AxTheB/Prusa3/box_frame/sample_stls/single_plate_gt2_lm8uu/README.md

# Single plate version with thicker smooth rods
Those parts are for use with *Prusa i3 (single plate) aluminium frame*. Frame blueprints are at https://github.com/josefprusa/Prusa3-vanilla/blob/master/src/alu-frame.dxf
From variable vitamins you need 2x *623 bearings*, 2x *gt2 Pulley with 18-25 teeth*, and a 6mm wide gt2 belts. The bearings are all *lm8uu* (10x) and smooth rods are 8mm.
You will also need extruder, included carriage will take one narrow (for example MGS or geared stepper based) or wade (see extras)
