AxTheB/Prusa3/box_frame/sample_stls/big_htd3_lm12luu/extras/tube_clamp.stl

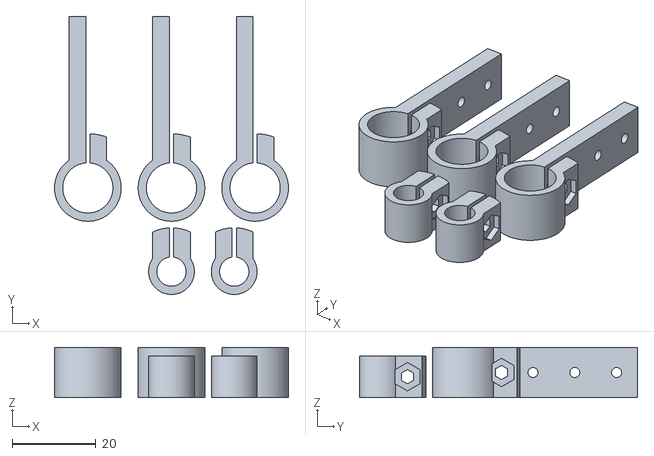
[picture p1: CAD file, 2014-03-03]
box_frame/sample_stls/big_htd3_lm12luu/extras/tube_clamp.stl
56.0 x 66.5 x 12.0
