AxTheB/Prusa3/box_frame/sample_stls/big_htd3_lm12luu/z-axis.stl

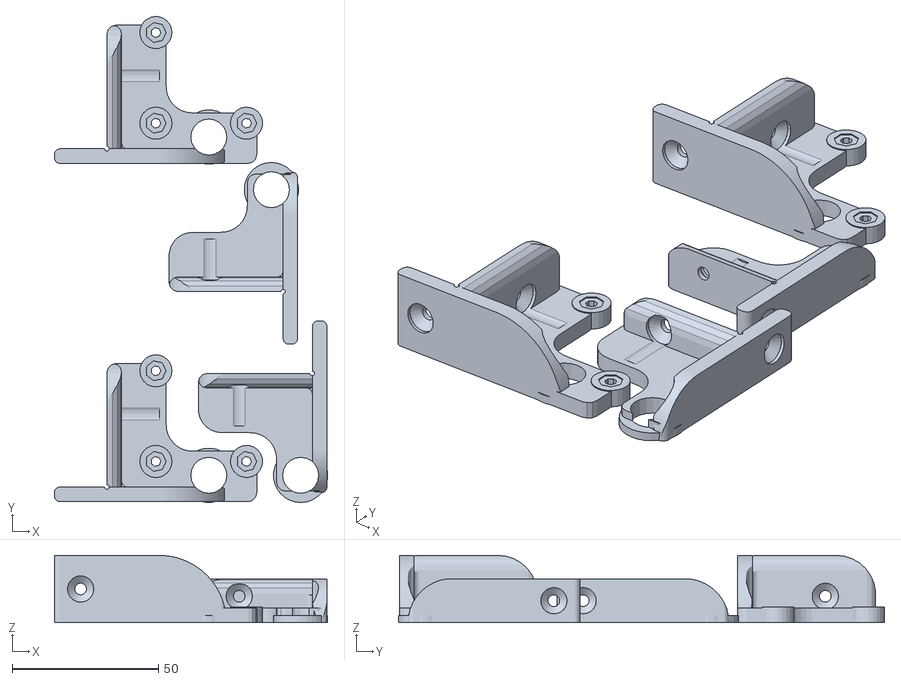
[picture p2: CAD file, 2014-03-03]
box_frame/sample_stls/big_htd3_lm12luu/z-axis.stl
93.5 x 166.2 x 23.0
