AxTheB/Prusa3/box_frame/sample_stls/default_box_gt2_lm10uu/extras/wade-gears.stl

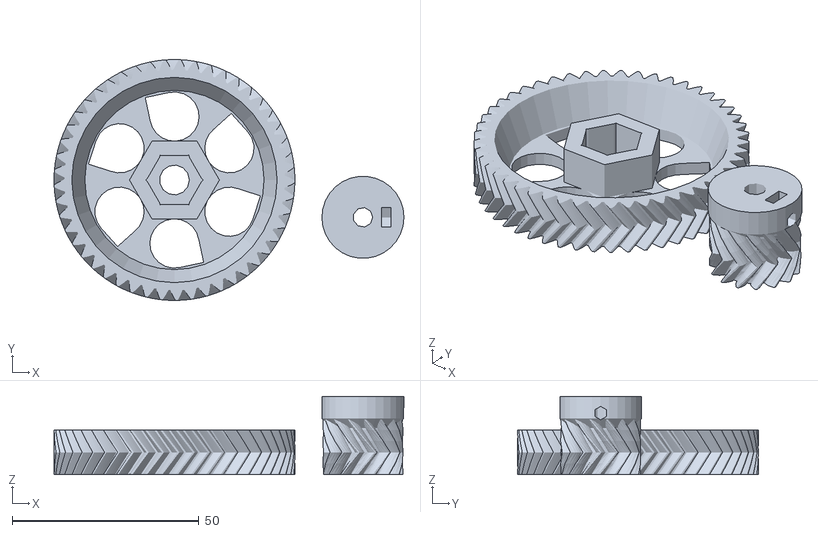
[picture p3: CAD file, 2014-03-03]
box_frame/sample_stls/default_box_gt2_lm10uu/extras/wade-gears.stl
93.8 x 64.5 x 21.0
