AxTheB/Prusa3/box_frame/sample_stls/default_box_gt2_lm10uu/y-drivetrain.stl

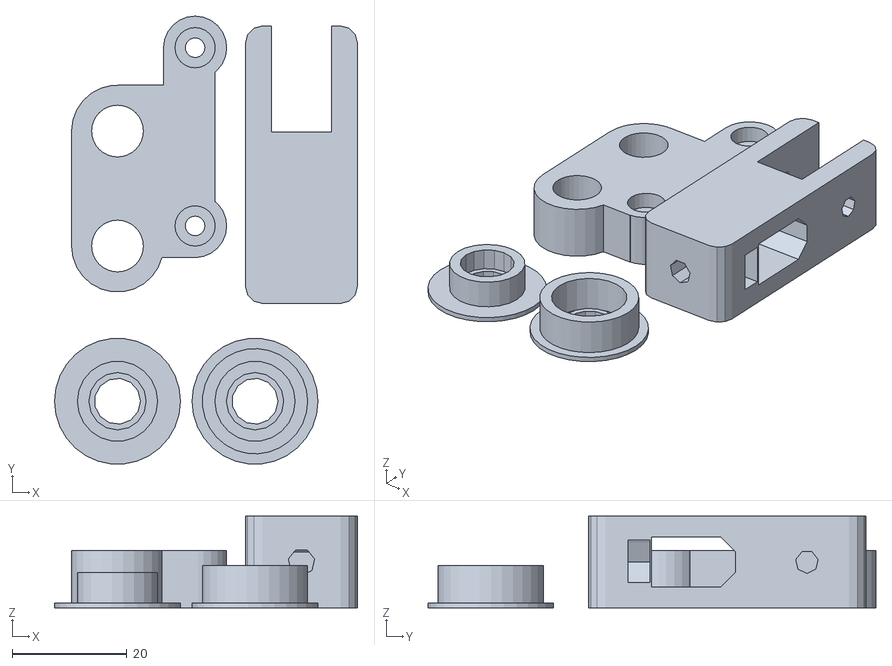
[picture p4: CAD file, 2014-03-03]
box_frame/sample_stls/default_box_gt2_lm10uu/y-drivetrain.stl
52.7 x 77.9 x 16.0
