AxTheB/Prusa3/box_frame/sample_stls/single_plate_gt2_lm8uu/extras/gregs-wade-v3.stl

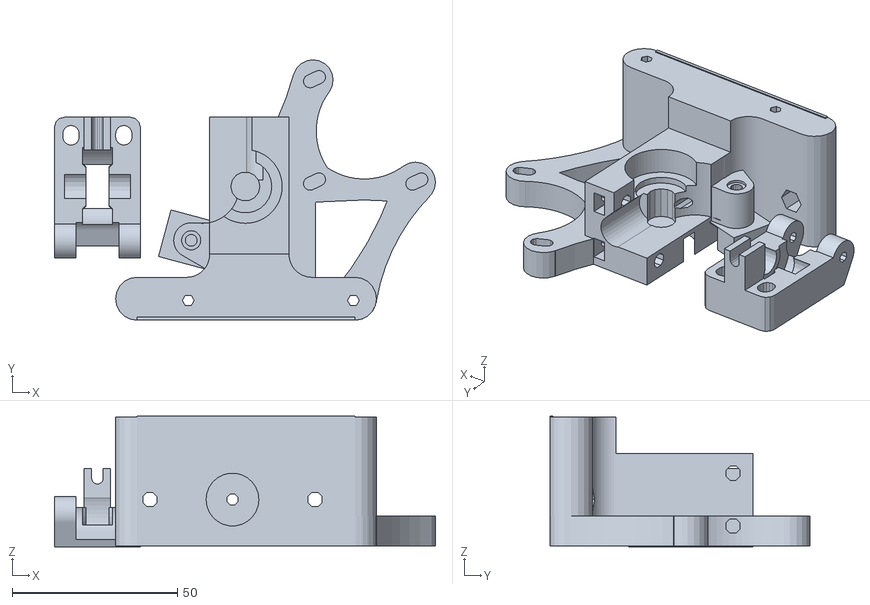
[picture p5: CAD file, 2014-03-03]
box_frame/sample_stls/single_plate_gt2_lm8uu/extras/gregs-wade-v3.stl
115.4 x 78.9 x 39.7
