AxTheB/Prusa3/box_frame/sample_stls/single_plate_gt2_lm8uu/y-axis-corner.stl

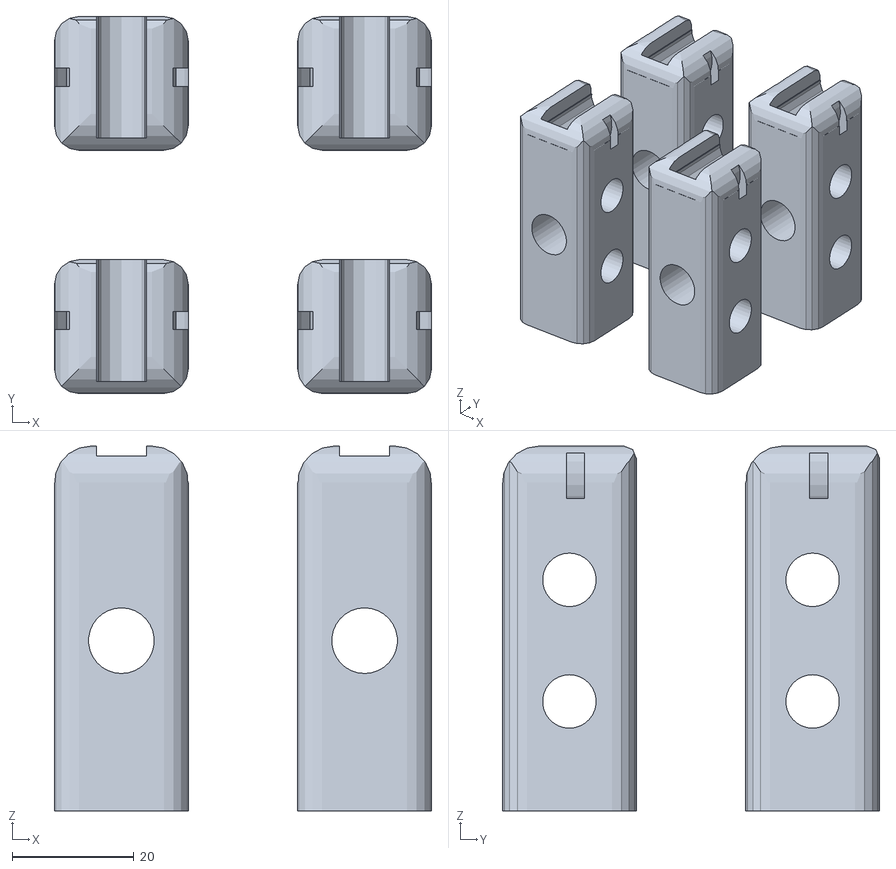
[picture p6: CAD file, 2014-03-03]
box_frame/sample_stls/single_plate_gt2_lm8uu/y-axis-corner.stl
62.0 x 62.0 x 60.0
