AxTheB/Prusa3/box_frame/sample_stls/big_htd3_lm12luu/extras/calibrate.stl

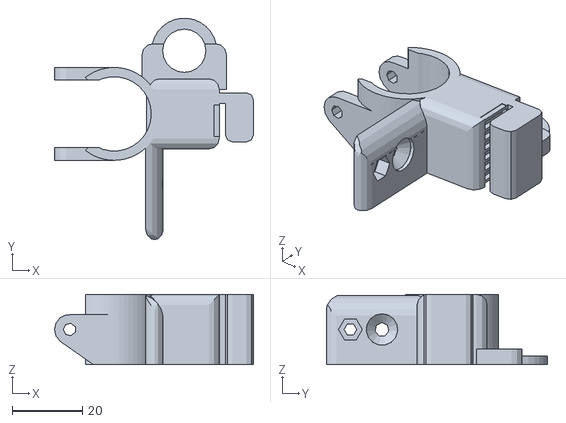
[picture p7: CAD file, 2014-02-11]
box_frame/sample_stls/big_htd3_lm12luu/extras/calibrate.stl
56.8 x 63.1 x 20.0
