AxTheB/Prusa3/box_frame/sample_stls/big_htd3_lm12luu/x-end.stl

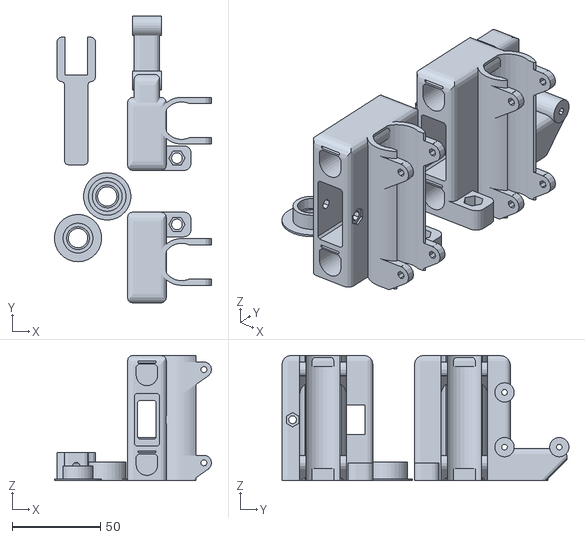
[picture p8: CAD file, 2014-03-03]
box_frame/sample_stls/big_htd3_lm12luu/x-end.stl
89.0 x 162.5 x 70.8
