AxTheB/Prusa3/box_frame/sample_stls/default_box_gt2_lm10uu/x-end.stl

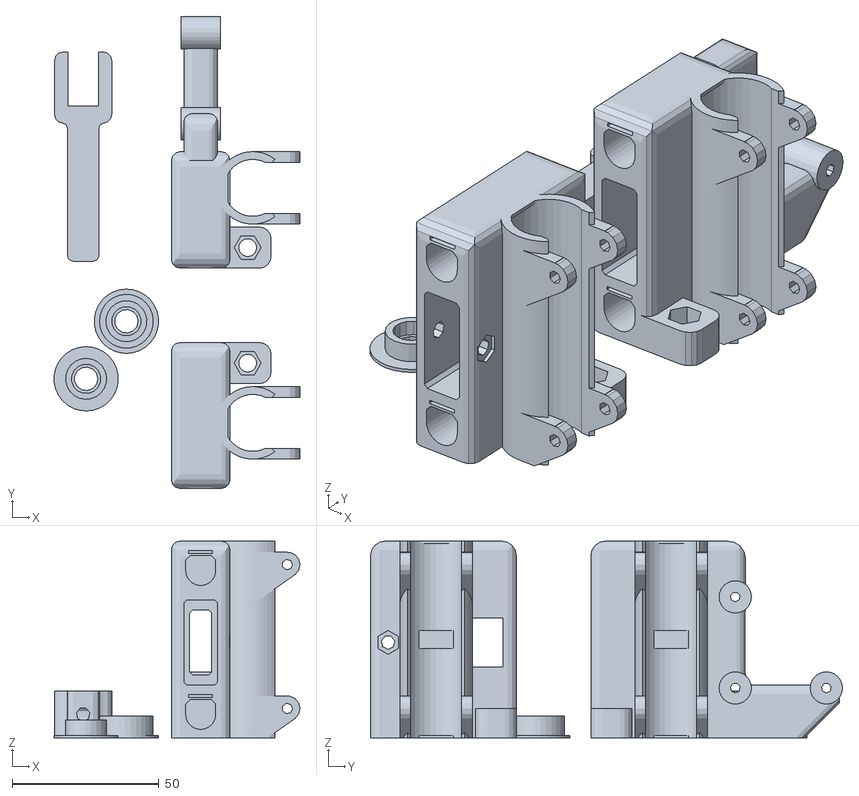
[picture p9: CAD file, 2014-03-03]
box_frame/sample_stls/default_box_gt2_lm10uu/x-end.stl
83.7 x 160.7 x 67.0
