AxTheB/Prusa3/box_frame/sample_stls/big_htd3_lm12luu/x-carriage.stl

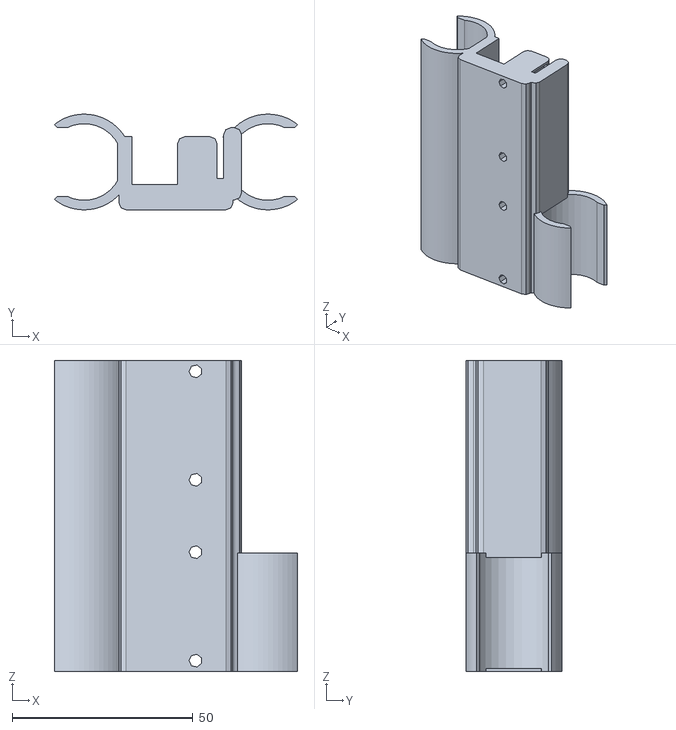
[picture p10: CAD file, 2014-03-03]
box_frame/sample_stls/big_htd3_lm12luu/x-carriage.stl
67.2 x 26.5 x 86.0
