AxTheB/Prusa3/box_frame/sample_stls/default_box_gt2_lm10uu/bushing.stl

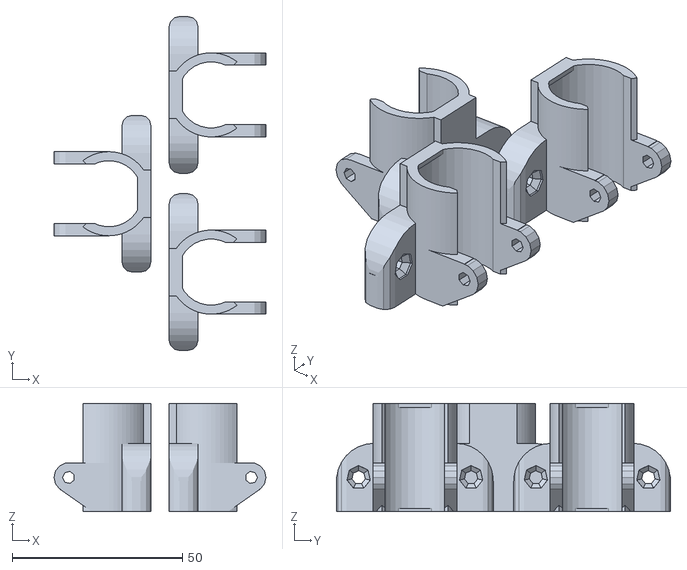
[picture p11: CAD file, 2014-03-03]
box_frame/sample_stls/default_box_gt2_lm10uu/bushing.stl
62.2 x 98.0 x 31.7
