AxTheB/Prusa3/box_frame/sample_stls/single_plate_gt2_lm8uu/extras/calibrate.stl

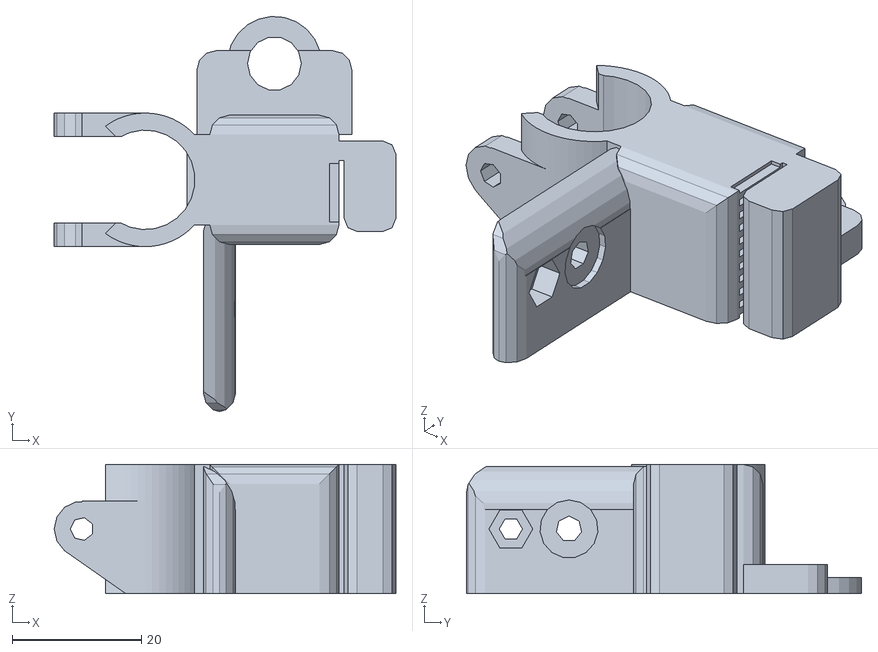
[picture p13: CAD file, 2014-02-11]
box_frame/sample_stls/single_plate_gt2_lm8uu/extras/calibrate.stl
52.9 x 61.1 x 20.0
