AxTheB/Prusa3/box_frame/sample_stls/single_plate_gt2_lm8uu/z-axis.stl

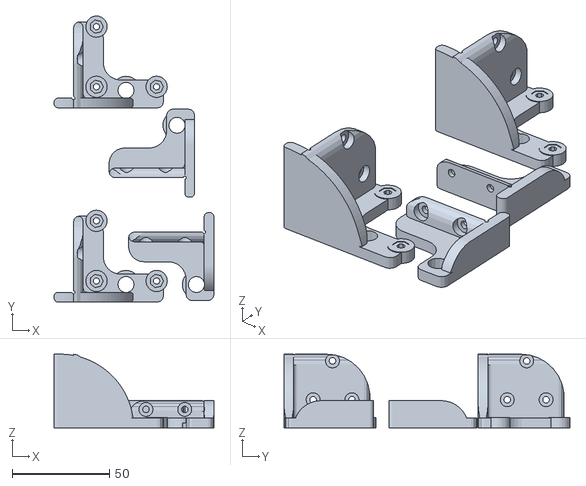
[picture p14: CAD file, 2014-03-03]
box_frame/sample_stls/single_plate_gt2_lm8uu/z-axis.stl
82.3 x 147.4 x 38.0
