AxTheB/Prusa3/box_frame/sample_stls/big_htd3_lm12luu/y-axis-corner.stl

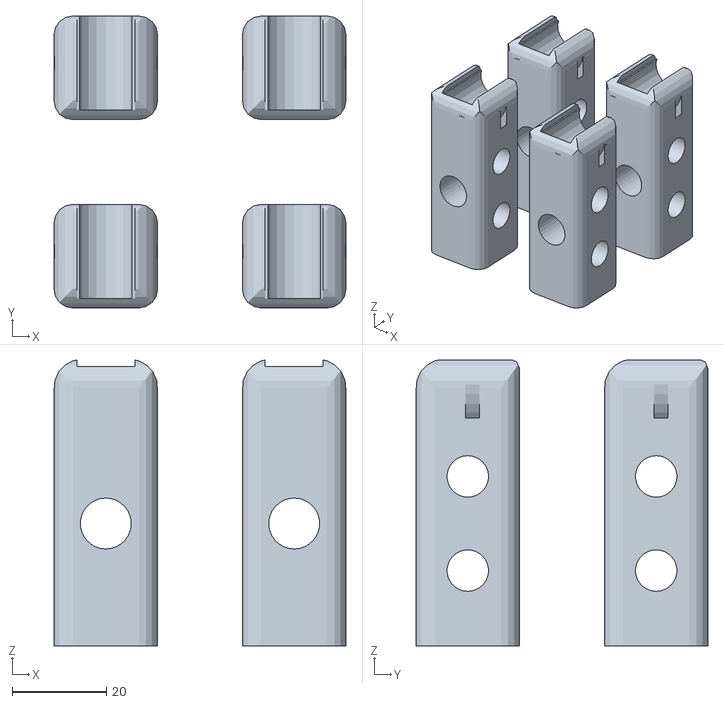
[picture p15: CAD file, 2014-02-19]
box_frame/sample_stls/big_htd3_lm12luu/y-axis-corner.stl
62.0 x 62.0 x 60.7
