AxTheB/Prusa3/box_frame/sample_stls/default_box_gt2_lm10uu/z-axis.stl

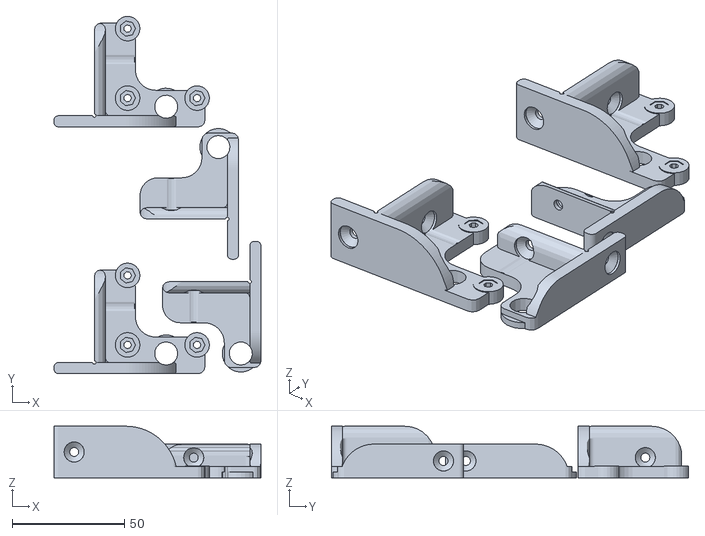
[picture p17: CAD file, 2014-03-03]
box_frame/sample_stls/default_box_gt2_lm10uu/z-axis.stl
92.3 x 159.4 x 23.0
