AxTheB/Prusa3/box_frame/sample_stls/single_plate_gt2_lm8uu/x-carriage.stl

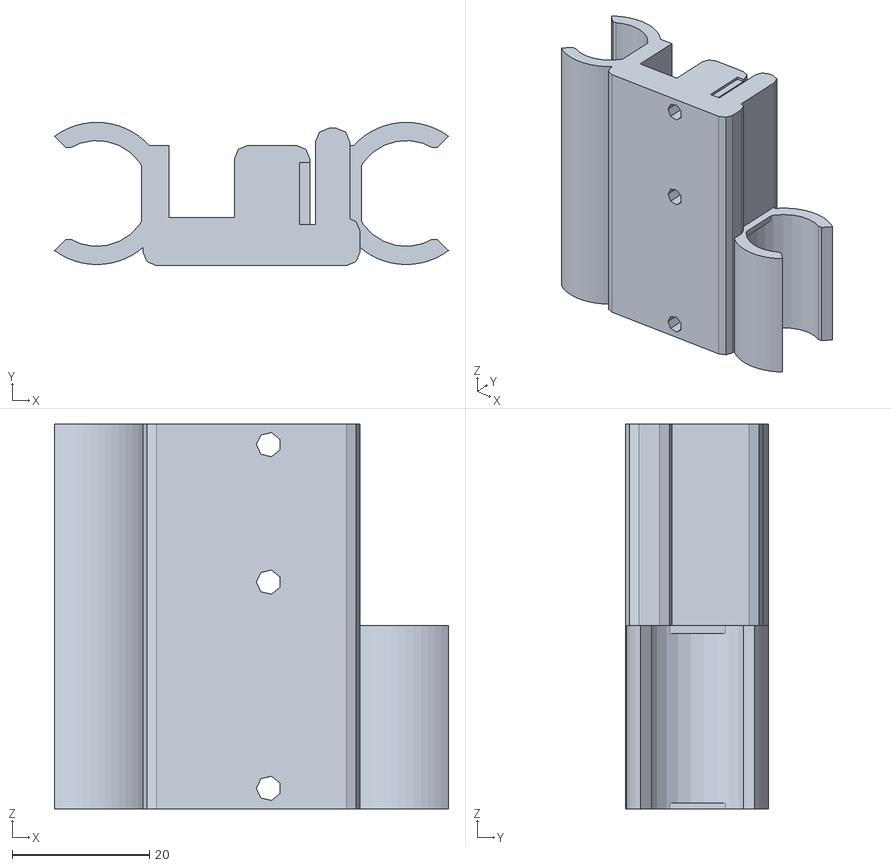
[picture p18: CAD file, 2014-03-03]
box_frame/sample_stls/single_plate_gt2_lm8uu/x-carriage.stl
57.3 x 20.8 x 56.0
