AxTheB/Prusa3/box_frame/sample_stls/big_htd3_lm12luu/bushing.stl

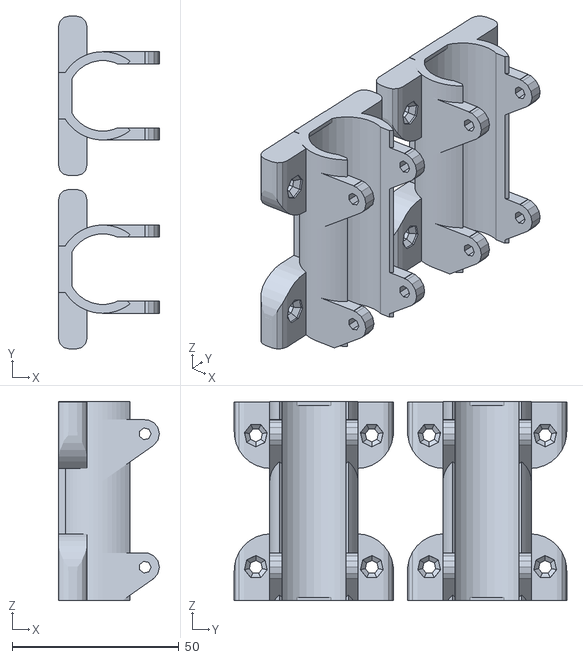
[picture p19: CAD file, 2014-02-19]
box_frame/sample_stls/big_htd3_lm12luu/bushing.stl
30.2 x 99.8 x 59.7
