AxTheB/Prusa3/box_frame/sample_stls/default_box_gt2_lm10uu/y-axis-bracket.stl

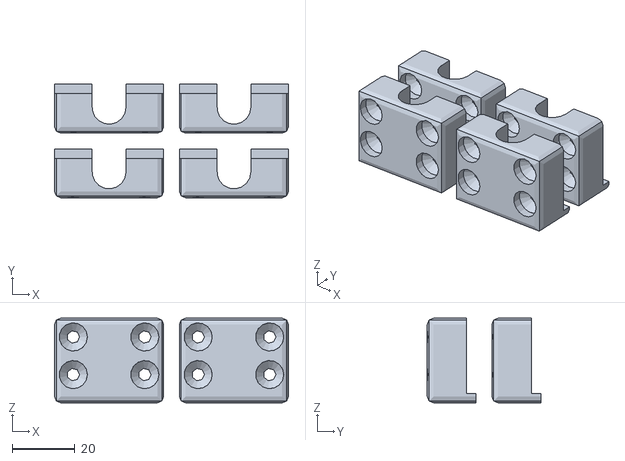
[picture p20: CAD file, 2014-03-03]
box_frame/sample_stls/default_box_gt2_lm10uu/y-axis-bracket.stl
74.6 x 36.2 x 27.0
