AxTheB/Prusa3/box_frame/sample_stls/single_plate_gt2_lm8uu/x-end.stl

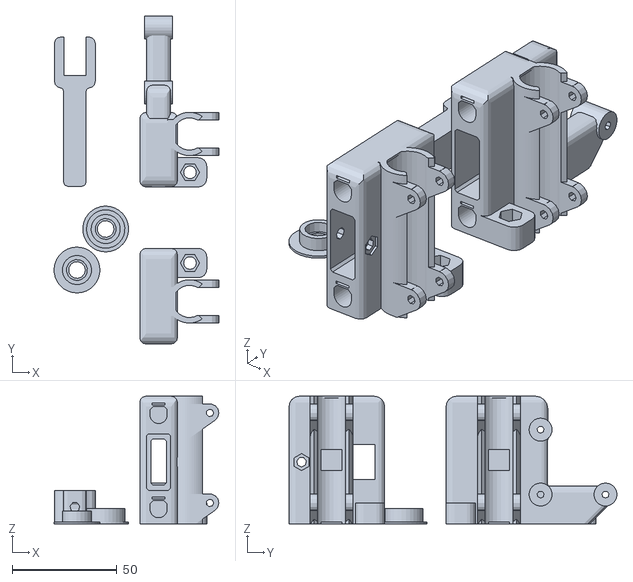
[picture p21: CAD file, 2014-03-03]
box_frame/sample_stls/single_plate_gt2_lm8uu/x-end.stl
78.7 x 156.7 x 61.0
