AxTheB/Prusa3/box_frame/sample_stls/big_htd3_lm12luu/y-belt-holder.stl

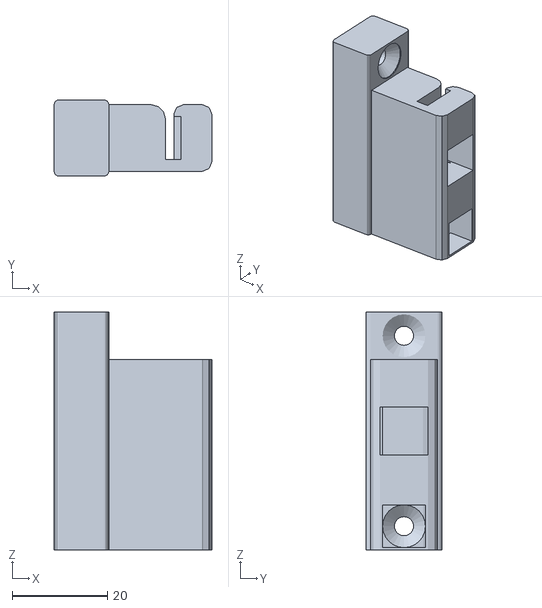
[picture p22: CAD file, 2014-02-11]
box_frame/sample_stls/big_htd3_lm12luu/y-belt-holder.stl
33.1 x 16.0 x 50.0
