AxTheB/Prusa3/box_frame/sample_stls/big_htd3_lm12luu/y-drivetrain.stl

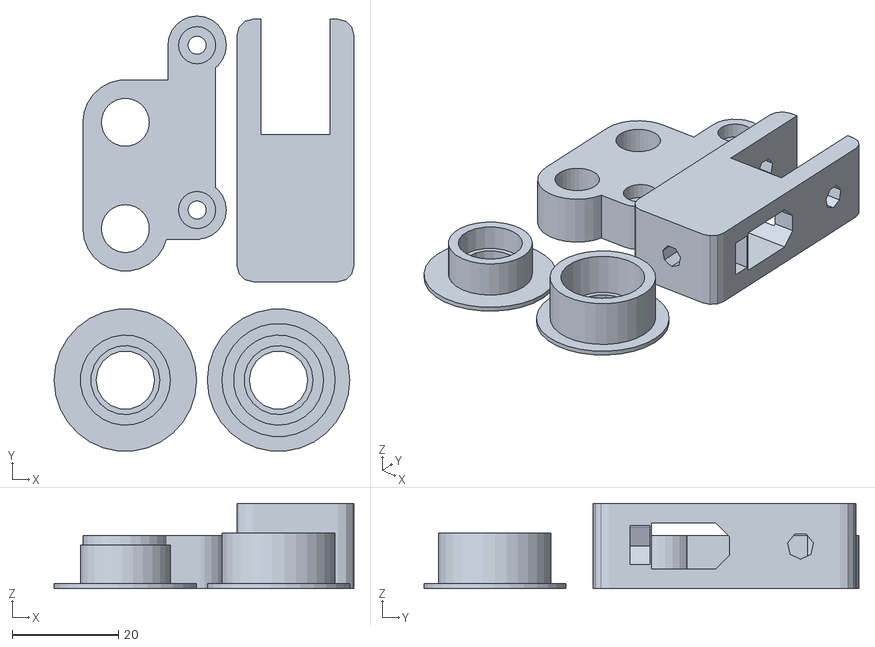
[picture p23: CAD file, 2014-02-11]
box_frame/sample_stls/big_htd3_lm12luu/y-drivetrain.stl
56.4 x 81.8 x 16.0
