AxTheB/Prusa3/box_frame/sample_stls/default_box_gt2_lm10uu/x-carriage.stl

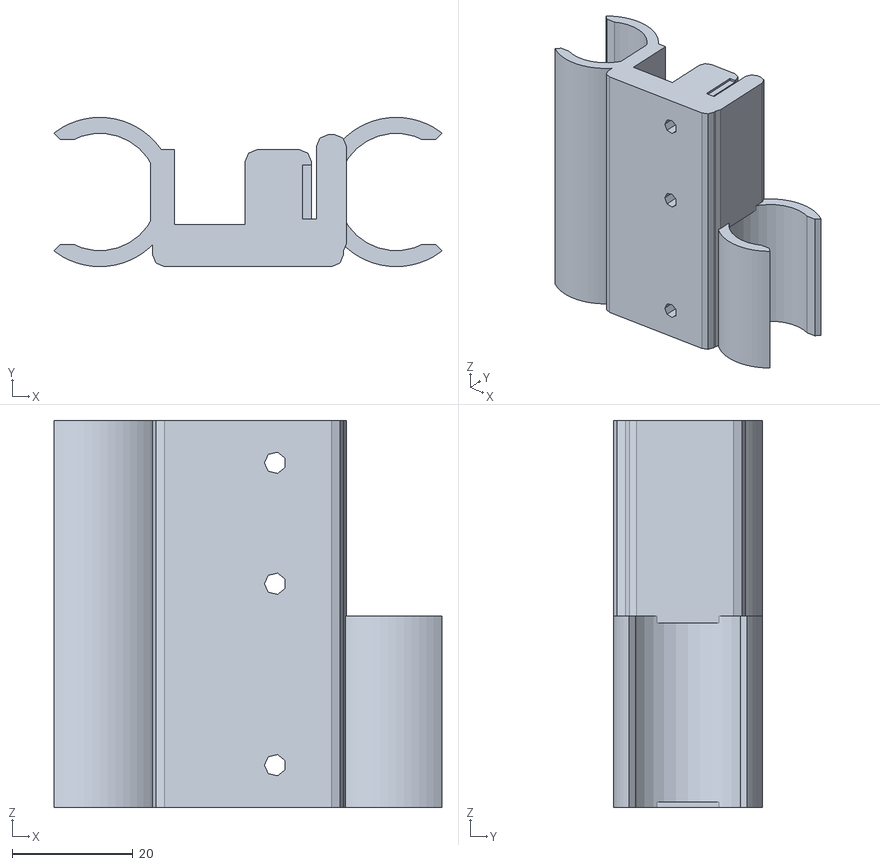
[picture p24: CAD file, 2014-02-19]
box_frame/sample_stls/default_box_gt2_lm10uu/x-carriage.stl
64.2 x 24.7 x 64.0
