AxTheB/Prusa3/box_frame/sample_stls/default_box_gt2_lm10uu/y-belt-holder.stl

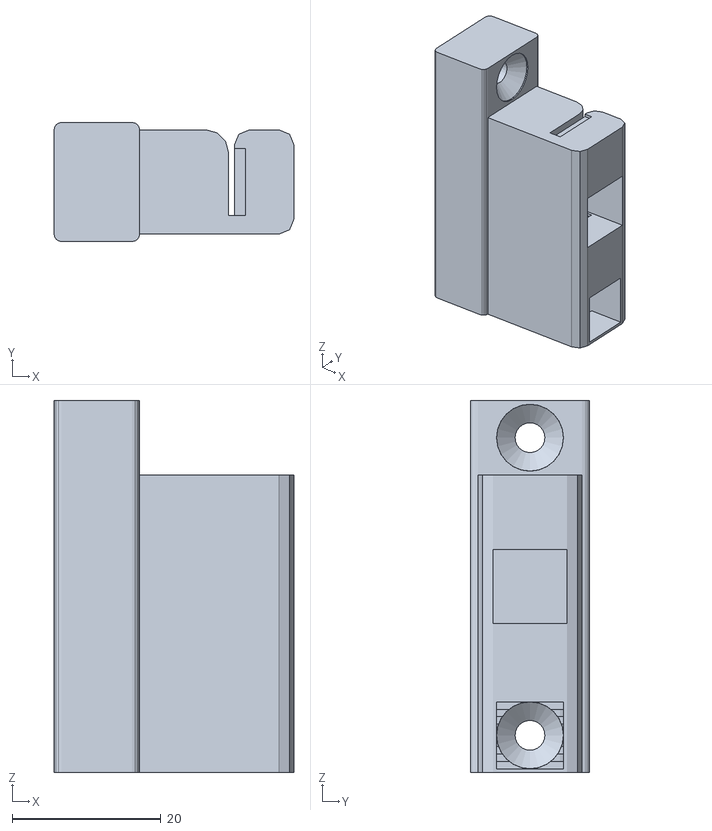
[picture p25: CAD file, 2014-02-11]
box_frame/sample_stls/default_box_gt2_lm10uu/y-belt-holder.stl
32.2 x 16.0 x 50.0
