AxTheB/Prusa3/(list of files, cad)

Other CAD files:
box_frame/sample_stls/default_box_gt2_lm10uu/extras/gregs-wade-v3.stl
box_frame/sample_stls/single_plate_gt2_lm8uu/extras/wade-gears.stl
box_frame/sample_stls/single_plate_gt2_lm8uu/y-drivetrain.stl
box_frame/sample_stls/default_box_gt2_lm10uu/y-axis-corner.stl
box_frame/doc/complete-printer.scad
box_frame/extras/endstop-holder.scad
box_frame/inc/conf_bushing.scad
box_frame/inc/metric.scad
box_frame/y-axis-bracket.scad
box_frame/y-belt-holder.scad
box_frame/y-drivetrain.scad
