AxTheB/Prusa3/(commit log)

2014-02-11 X axis rewite, variable X rod distance and more parametric love.
    [bearing-guide.scad, bushing.scad, bushing.stl, calibrate.stl, complete-printer-plus.scad, configuration.scad, functions.scad, gregs-wade-v3.stl]
2014-02-11 Fix wrong bearing sizes in readme
2014-02-17 ziptie for Y corners
    [y-axis-corner.scad]
2014-02-19 add idler to thingdoc
    [x-end.scad]
2014-02-19 regenrate sample stls
    [bushing.stl, calibrate.stl, gregs-wade-v3.stl, tube_clamp.stl, wade-gears.stl, x-carriage.stl, x-end.stl, y-axis-bracket.stl]
2014-03-03 Deal with thick carriages
    [settings.scad, z-axis.scad]
2014-03-03 More sturdy gears
    [wade-gears.scad]
2014-03-03 Parametric m8 hole in wade
    [gregs-wade-v3.scad]
2014-03-03 Regenerate samples
    [bushing.stl, calibrate.stl, gregs-wade-v3.stl, tube_clamp.stl, wade-gears.stl, x-carriage.stl, x-end.stl, y-axis-bracket.stl]
